EI2030/Caster/pcb/fpga.kicad_sch

## KiCad design pcb/fpga.kicad_sch (2021-05-30)

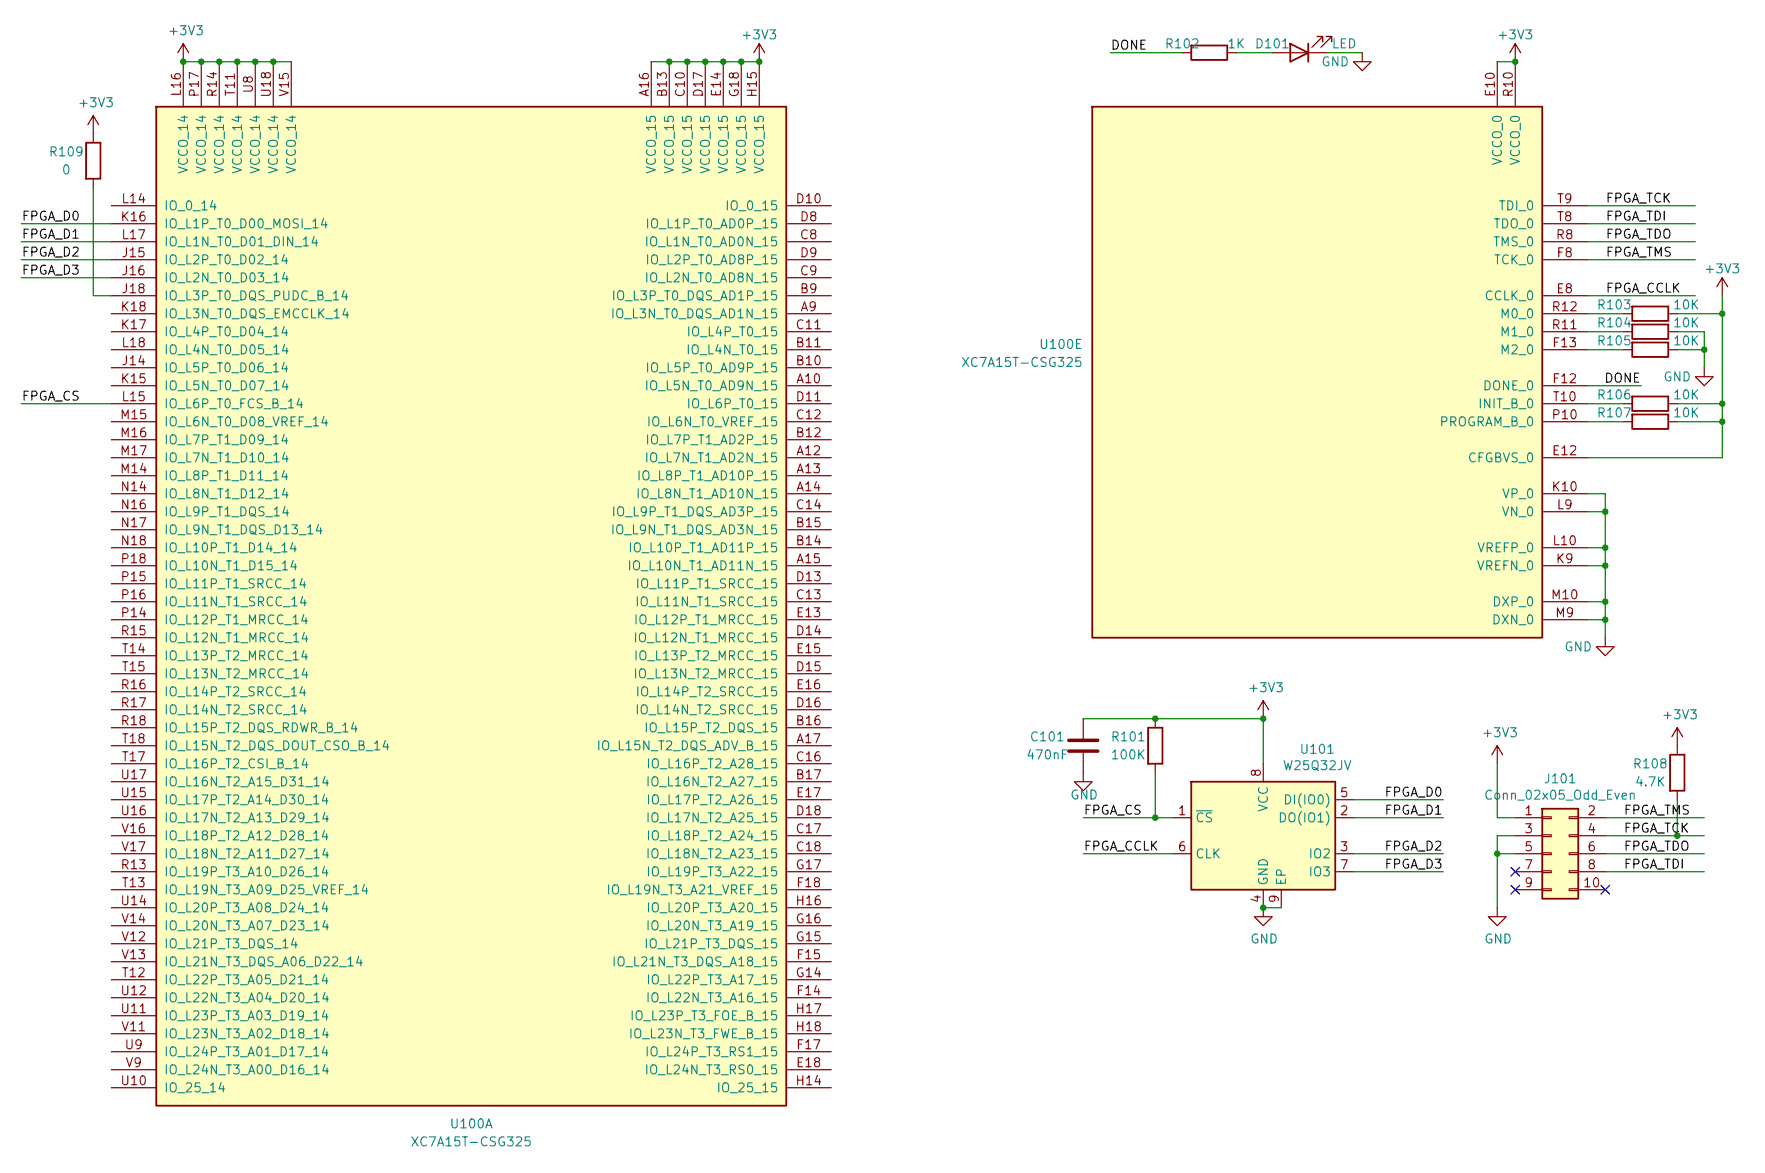
[picture p1: schematic fpga.kicad_sch]

Parts:
C101: 470nF; C_0402_1005Metric
D101: LED; D_0603_1608Metric
J101: Conn_02x05_Odd_Even; PinHeader_2x05_P1.27mm_Vertical_SMD
R101: 100K; C_0402_1005Metric
R102: 1K; R_0402_1005Metric
R103, R104, R105, R106, R107: 10K; R_0402_1005Metric
R108: 4.7K; R_0402_1005Metric
R109: 0; C_0402_1005Metric
U100: XC7A15T-CSG325; Xilinx_CSG325
U101: W25Q32JV; WSON-8-1EP_6x5mm_P1.27mm_EP3.4x4.3mm

Connections:
+3V3: C101.2, J101.1, R101.1, R103.1, R106.1, R107.1, R108.1, R109.1, U100.A16 (VCCO_15), U100.B13 (VCCO_15), U100.C10 (VCCO_15), U100.D17 (VCCO_15), U100.E10 (VCCO_0), U100.E12 (CFGBVS_0), U100.E14 (VCCO_15), U100.G18 (VCCO_15), U100.H15 (VCCO_15), U100.L16 (VCCO_14), U100.P17 (VCCO_14), U100.R10 (VCCO_0), U100.R14 (VCCO_14), U100.T11 (VCCO_14), U100.U8 (VCCO_14), U100.U18 (VCCO_14), U100.V15 (VCCO_14), U101.8 (VCC)
DONE: R102.2, U100.F12 (DONE_0)
FPGA_CCLK: U100.E8 (CCLK_0), U101.6 (CLK)
FPGA_CS: R101.2, U100.L15 (IO_L6P_T0_FCS_B_14), U101.1 (~CS)
FPGA_D0: U100.K16 (IO_L1P_T0_D00_MOSI_14), U101.5 (DI(IO0))
FPGA_D1: U100.L17 (IO_L1N_T0_D01_DIN_14), U101.2 (DO(IO1))
FPGA_D2: U100.J15 (IO_L2P_T0_D02_14), U101.3 (IO2)
FPGA_D3: U100.J16 (IO_L2N_T0_D03_14), U101.7 (IO3)
FPGA_TCK: J101.4, R108.2, U100.T9 (TDI_0)
FPGA_TDI: J101.8, U100.T8 (TDO_0)
FPGA_TDO: J101.6, U100.R8 (TMS_0)
FPGA_TMS: J101.2, U100.F8 (TCK_0)
GND: C101.1, D101.1 (K), J101.3, J101.5, R104.1, R105.1, U100.K9 (VREFN_0), U100.K10 (VP_0), U100.L9 (VN_0), U100.L10 (VREFP_0), U100.M9 (DXN_0), U100.M10 (DXP_0), U101.4 (GND), U101.9 (EP)
unnamed: D101.2 (A), R102.1
unnamed: R103.2, U100.R12 (M0_0)
unnamed: R104.2, U100.R11 (M1_0)
unnamed: R105.2, U100.F13 (M2_0)
unnamed: R106.2, U100.T10 (INIT_B_0)
unnamed: R107.2, U100.P10 (PROGRAM_B_0)
unnamed: R109.2, U100.J18 (IO_L3P_T0_DQS_PUDC_B_14)
