EI2030/Caster/pcb/lvds.kicad_sch

## KiCad design pcb/lvds.kicad_sch (2021-05-30)

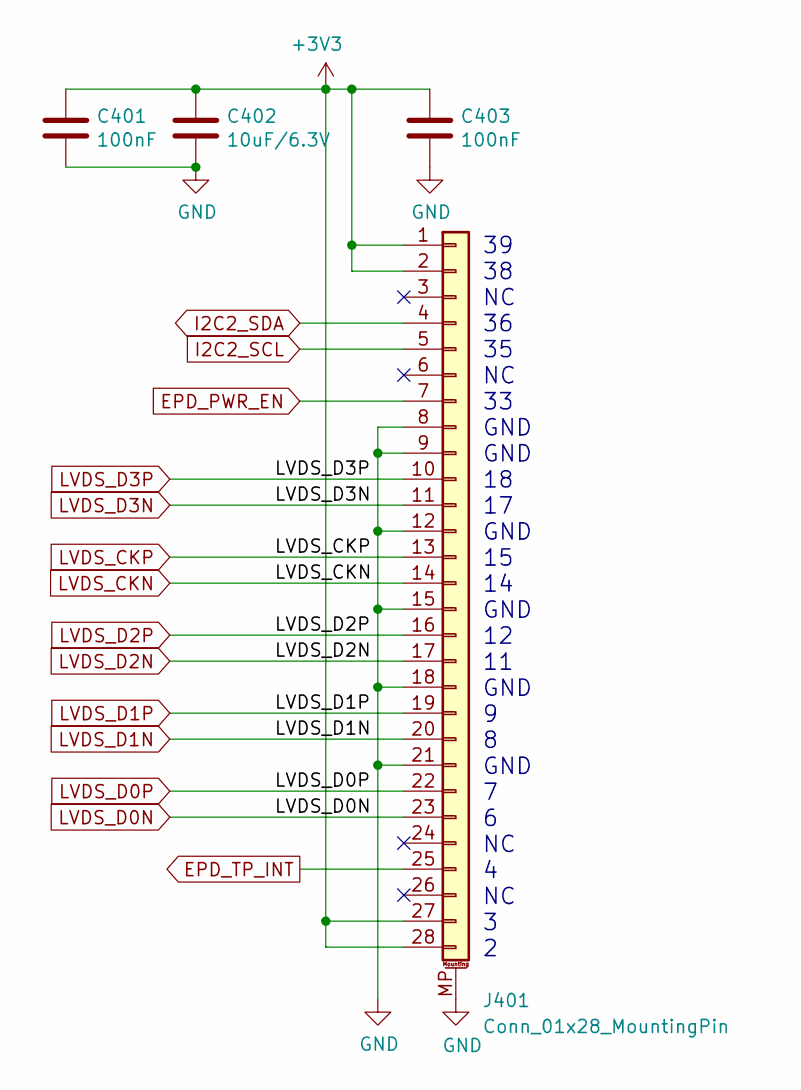
[picture p2: schematic lvds.kicad_sch]

Parts:
C401, C403: 100nF; C_0402_1005Metric
C402: 10uF/6.3V; C_0603_1608Metric
J401: Conn_01x28_MountingPin; Hirose_FH12-28S-0.5SH_1x28-1MP_P0.50mm_Horizontal

Connections:
+3V3: C401.1, C402.1, C403.1, J401.1, J401.2, J401.27, J401.28
EPD_PWR_EN: J401.7
EPD_TP_INT: J401.25
GND: C401.2, C402.2, C403.2, J401.8, J401.9, J401.12, J401.15, J401.18, J401.21, J401.MP (MountPin)
I2C2_SCL: J401.5
I2C2_SDA: J401.4
LVDS_CKN: J401.14
LVDS_CKP: J401.13
LVDS_D0N: J401.23
LVDS_D0P: J401.22
LVDS_D1N: J401.20
LVDS_D1P: J401.19
LVDS_D2N: J401.17
LVDS_D2P: J401.16
LVDS_D3N: J401.11
LVDS_D3P: J401.10

Notes on the sheet:
39 38 NC 36 35 NC 33 GND GND 18 17 GND 15 14 GND 12 11 GND 9 8 GND 7 6 NC 4 NC 3 2
