EI2030/Caster/pcb/pcie.kicad_sch

## KiCad design pcb/pcie.kicad_sch (2021-05-30)

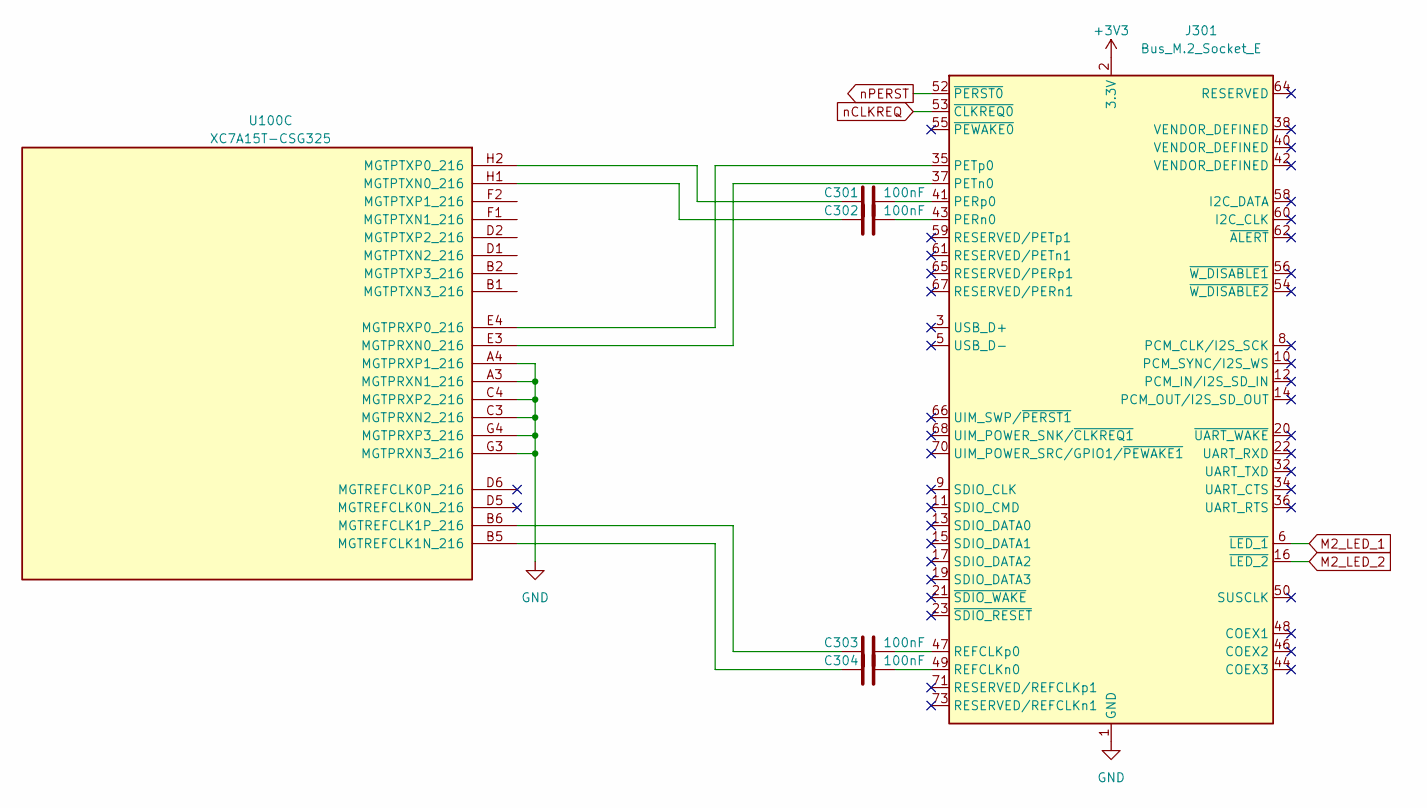
[picture p3: schematic pcie.kicad_sch]

Parts:
C301, C302, C303, C304: 100nF; C_0402_1005Metric
J301: Bus_M.2_Socket_E; m2-padKeyAE
U100: XC7A15T-CSG325; Xilinx_CSG325

Connections:
+3V3: J301.2 (3.3V), J301.4 (3.3V), J301.72 (3.3V), J301.74 (3.3V)
GND: J301.1 (GND), J301.7 (GND), J301.18 (GND), J301.33 (GND), J301.39 (GND), J301.45 (GND), J301.51 (GND), J301.57 (GND), J301.63 (GND), J301.69 (GND), J301.75 (GND), U100.A3 (MGTPRXN1_216), U100.A4 (MGTPRXP1_216), U100.C3 (MGTPRXN2_216), U100.C4 (MGTPRXP2_216), U100.G3 (MGTPRXN3_216), U100.G4 (MGTPRXP3_216)
M2_LED_1: J301.6 (~LED_1)
M2_LED_2: J301.16 (~LED_2)
unnamed: C301.1, U100.H2 (MGTPTXP0_216)
unnamed: C301.2, J301.41 (PERp0)
unnamed: C302.1, U100.H1 (MGTPTXN0_216)
unnamed: C302.2, J301.43 (PERn0)
unnamed: C303.1, U100.B6 (MGTREFCLK1P_216)
unnamed: C303.2, J301.47 (REFCLKp0)
unnamed: C304.1, U100.B5 (MGTREFCLK1N_216)
unnamed: C304.2, J301.49 (REFCLKn0)
unnamed: J301.35 (PETp0), U100.E4 (MGTPRXP0_216)
unnamed: J301.37 (PETn0), U100.E3 (MGTPRXN0_216)
nCLKREQ: J301.53 (~CLKREQ0)
nPERST: J301.52 (~PERST0)
