EI2030/Caster/pcb/power.kicad_sch

## KiCad design pcb/power.kicad_sch (2021-05-30)

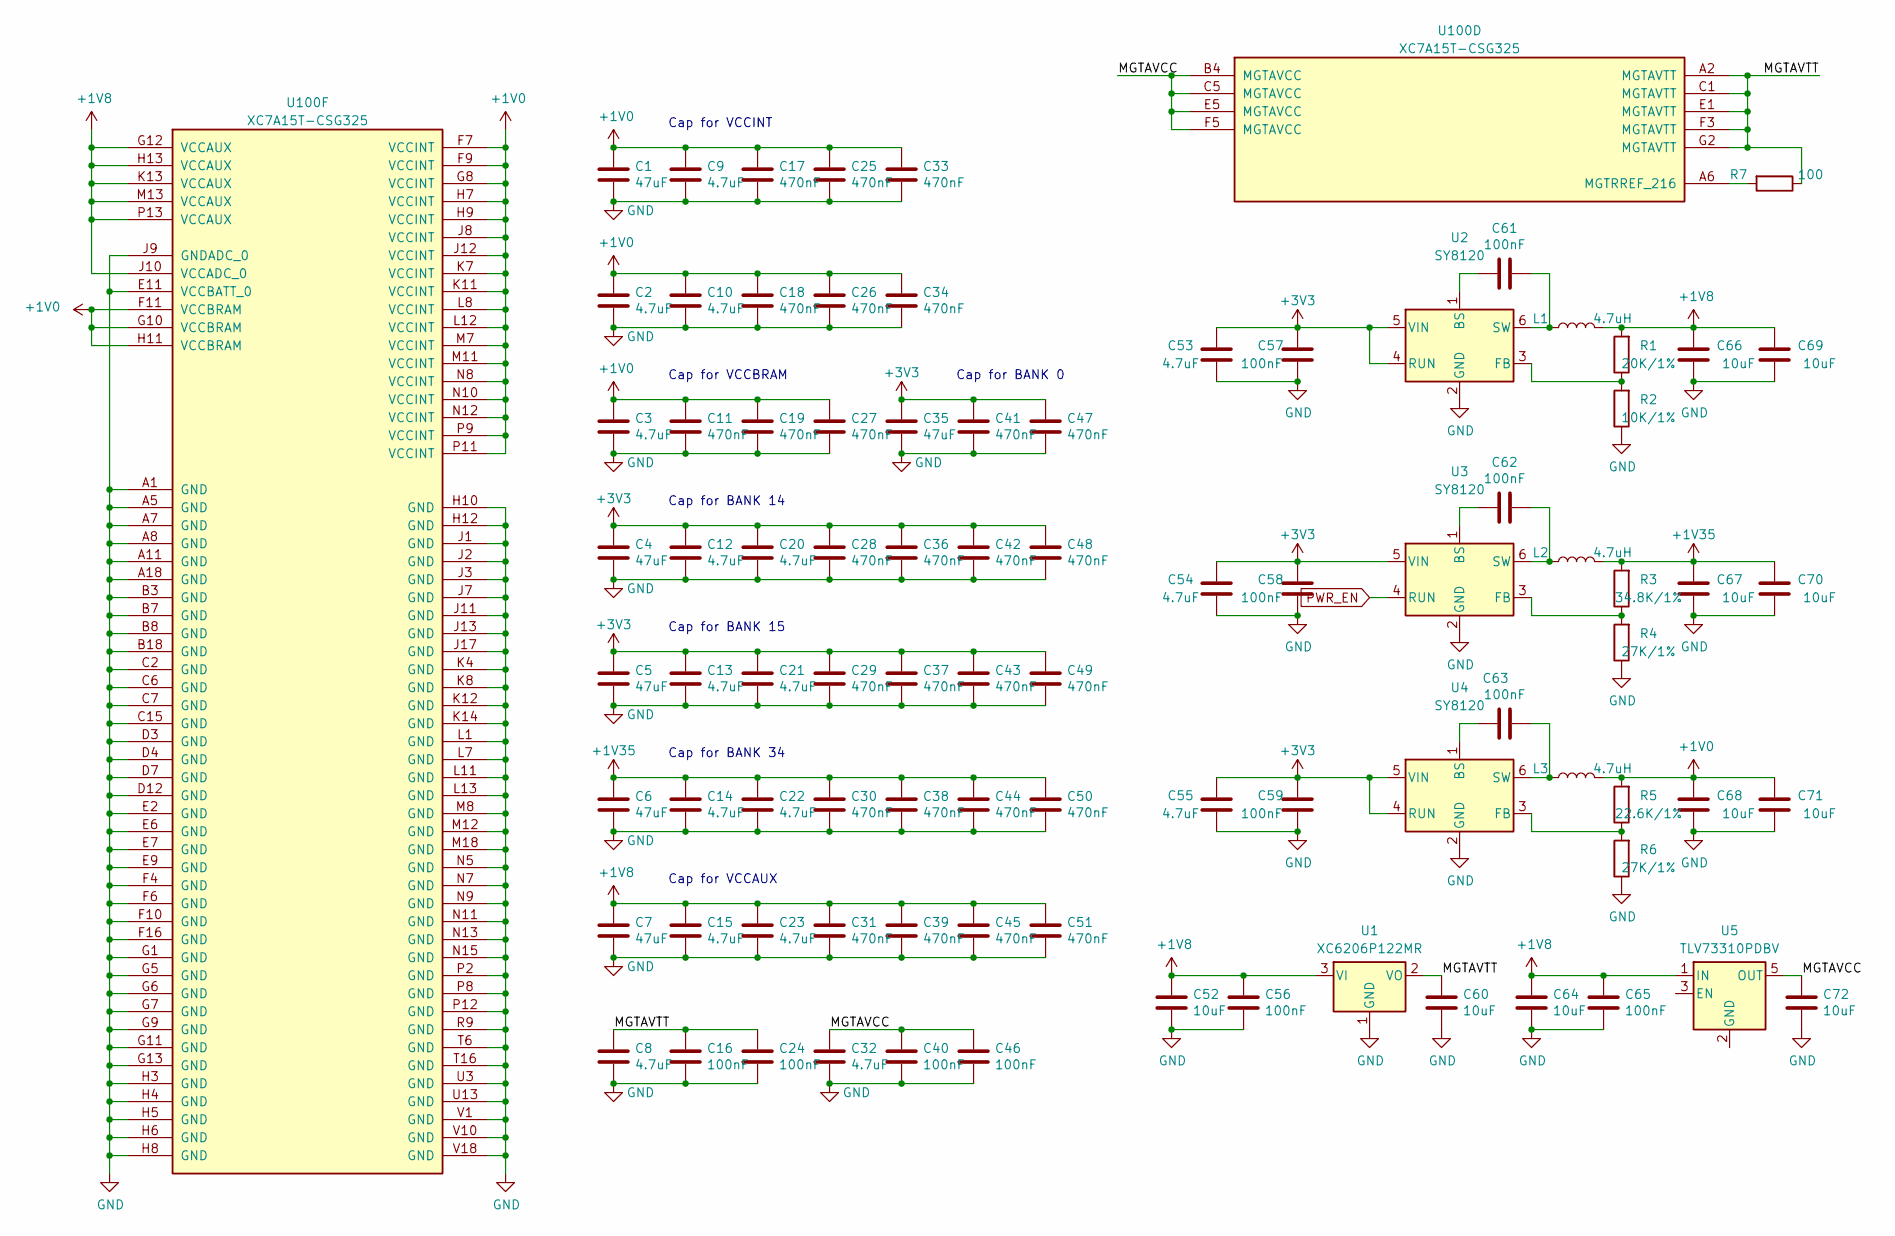
[picture p4: schematic power.kicad_sch]

Parts:
C1, C4, C5, C6, C7, C35: 47uF; C_0603_1608Metric
C2, C3, C8, C9, C10, C12, C13, C14, C15, C20, C21, C22, C23, C32, C53, C54, C55: 4.7uF; C_0402_1005Metric
C11, C17, C18, C19, C25, C26, C27, C28, C29, C30, C31, C33, C34, C36, C37, C38, C39, C41, C42, C43, C44, C45, C47, C48, C49, C50, C51: 470nF; C_0402_1005Metric
C16, C24, C40, C46, C56, C57, C58, C59, C61, C62, C63, C65: 100nF; C_0402_1005Metric
C52, C60, C64, C66, C67, C68, C69, C70, C71, C72: 10uF; C_0603_1608Metric
L1, L2, L3: 4.7uH; L_Vishay_IHLP-1212
R1: 20K/1%; R_0402_1005Metric
R2: 10K/1%; R_0402_1005Metric
R3: 34.8K/1%; R_0402_1005Metric
R4, R6: 27K/1%; R_0402_1005Metric
R5: 22.6K/1%; R_0402_1005Metric
R7: 100; R_0402_1005Metric
U1: XC6206P122MR; SOT-23
U2, U3, U4: SY8120; TSOT-23-6
U5: TLV73310PDBV; SOT-23-5
U100: XC7A15T-CSG325; Xilinx_CSG325

Connections:
+1V0: C1.1, C2.1, C3.1, C9.1, C10.1, C11.1, C17.1, C18.1, C19.1, C25.1, C26.1, C27.1, C33.1, C34.1, C68.2, C71.2, L3.2, R5.2, U100.F7 (VCCINT), U100.F9 (VCCINT), U100.F11 (VCCBRAM), U100.G8 (VCCINT), U100.G10 (VCCBRAM), U100.H7 (VCCINT), U100.H9 (VCCINT), U100.H11 (VCCBRAM), U100.J8 (VCCINT), U100.J12 (VCCINT), U100.K7 (VCCINT), U100.K11 (VCCINT), U100.L8 (VCCINT), U100.L12 (VCCINT), U100.M7 (VCCINT), U100.M11 (VCCINT), U100.N8 (VCCINT), U100.N10 (VCCINT), U100.N12 (VCCINT), U100.P9 (VCCINT), U100.P11 (VCCINT)
+1V8: C7.1, C15.1, C23.1, C31.1, C39.1, C45.1, C51.1, C52.1, C56.1, C64.1, C65.1, C66.2, C69.2, L1.2, R1.2, U1.3 (VI), U5.1 (IN), U100.G12 (VCCAUX), U100.H13 (VCCAUX), U100.J10 (VCCADC_0), U100.K13 (VCCAUX), U100.M13 (VCCAUX), U100.P13 (VCCAUX)
+1V35: C6.1, C14.1, C22.1, C30.1, C38.1, C44.1, C50.1, C67.2, C70.2, L2.2, R3.2
+3V3: C4.1, C5.1, C12.1, C13.1, C20.1, C21.1, C28.1, C29.1, C35.1, C36.1, C37.1, C41.1, C42.1, C43.1, C47.1, C48.1, C49.1, C53.2, C54.2, C55.2, C57.2, C58.2, C59.2, U2.4 (RUN), U2.5 (VIN), U3.5 (VIN), U4.4 (RUN), U4.5 (VIN)
GND: C1.2, C2.2, C3.2, C4.2, C5.2, C6.2, C7.2, C8.2, C9.2, C10.2, C11.2, C12.2, C13.2, C14.2, C15.2, C16.2, C17.2, C18.2, C19.2, C20.2, C21.2, C22.2, C23.2, C24.2, C25.2, C26.2, C27.2, C28.2, C29.2, C30.2, C31.2, C32.2, C33.2, C34.2, C35.2, C36.2, C37.2, C38.2, C39.2, C40.2, C41.2, C42.2, C43.2, C44.2, C45.2, C46.2, C47.2, C48.2, C49.2, C50.2, C51.2, C52.2, C53.1, C54.1, C55.1, C56.2, C57.1, C58.1, C59.1, C60.2, C64.2, C65.2, C66.1, C67.1, C68.1, C69.1, C70.1, C71.1, C72.2, R2.1, R4.1, R6.1, U1.1 (GND), U2.2 (GND), U3.2 (GND), U4.2 (GND), U100.A1 (GND), U100.A5 (GND), U100.A7 (GND), U100.A8 (GND), U100.A11 (GND), U100.A18 (GND), U100.B3 (GND), U100.B7 (GND), U100.B8 (GND), U100.B18 (GND), U100.C2 (GND), U100.C6 (GND), U100.C7 (GND), U100.C15 (GND), U100.D3 (GND), U100.D4 (GND), U100.D7 (GND), U100.D12 (GND), U100.E2 (GND), U100.E6 (GND), U100.E7 (GND), U100.E9 (GND), U100.E11 (VCCBATT_0), U100.F4 (GND), U100.F6 (GND), U100.F10 (GND), U100.F16 (GND), U100.G1 (GND), U100.G5 (GND), U100.G6 (GND), U100.G7 (GND), U100.G9 (GND), U100.G11 (GND), U100.G13 (GND), U100.H3 (GND), U100.H4 (GND), U100.H5 (GND), U100.H6 (GND), U100.H8 (GND), U100.H10 (GND), U100.H12 (GND), U100.J1 (GND), U100.J2 (GND), U100.J3 (GND), U100.J7 (GND), U100.J9 (GNDADC_0), U100.J11 (GND), U100.J13 (GND), U100.J17 (GND), U100.K4 (GND), U100.K8 (GND), U100.K12 (GND), U100.K14 (GND), U100.L1 (GND), U100.L7 (GND), U100.L11 (GND), U100.L13 (GND), U100.M8 (GND), U100.M12 (GND), U100.M18 (GND), U100.N5 (GND), U100.N7 (GND), U100.N9 (GND), U100.N11 (GND), U100.N13 (GND), U100.N15 (GND), U100.P2 (GND), U100.P8 (GND), U100.P12 (GND), U100.R9 (GND), U100.T6 (GND), U100.T16 (GND), U100.U3 (GND), U100.U13 (GND), U100.V1 (GND), U100.V10 (GND), U100.V18 (GND)
MGTAVCC: C32.1, C40.1, C46.1, C72.1, U5.5 (OUT), U100.B4 (MGTAVCC), U100.C5 (MGTAVCC), U100.E5 (MGTAVCC), U100.F5 (MGTAVCC)
MGTAVTT: C8.1, C16.1, C24.1, C60.1, R7.1, U1.2 (VO), U100.A2 (MGTAVTT), U100.C1 (MGTAVTT), U100.E1 (MGTAVTT), U100.F3 (MGTAVTT), U100.G2 (MGTAVTT)
unnamed: C61.1, L1.1, U2.6 (SW)
unnamed: C61.2, U2.1 (BS)
unnamed: C62.1, L2.1, U3.6 (SW)
unnamed: C62.2, U3.1 (BS)
unnamed: C63.1, L3.1, U4.6 (SW)
unnamed: C63.2, U4.1 (BS)
unnamed: R1.1, R2.2, U2.3 (FB)
unnamed: R3.1, R4.2, U3.3 (FB)
unnamed: R5.1, R6.2, U4.3 (FB)
unnamed: R7.2, U100.A6 (MGTRREF_216)
PWR_EN: U3.4 (RUN)

Notes on the sheet:
Cap for VCCINT
Cap for VCCBRAM
Cap for BANK 14
Cap for BANK 15
Cap for BANK 34
Cap for VCCAUX
Cap for BANK 0
