EI2030/Caster/pcb/ram.kicad_sch

## KiCad design pcb/ram.kicad_sch (2021-05-30)

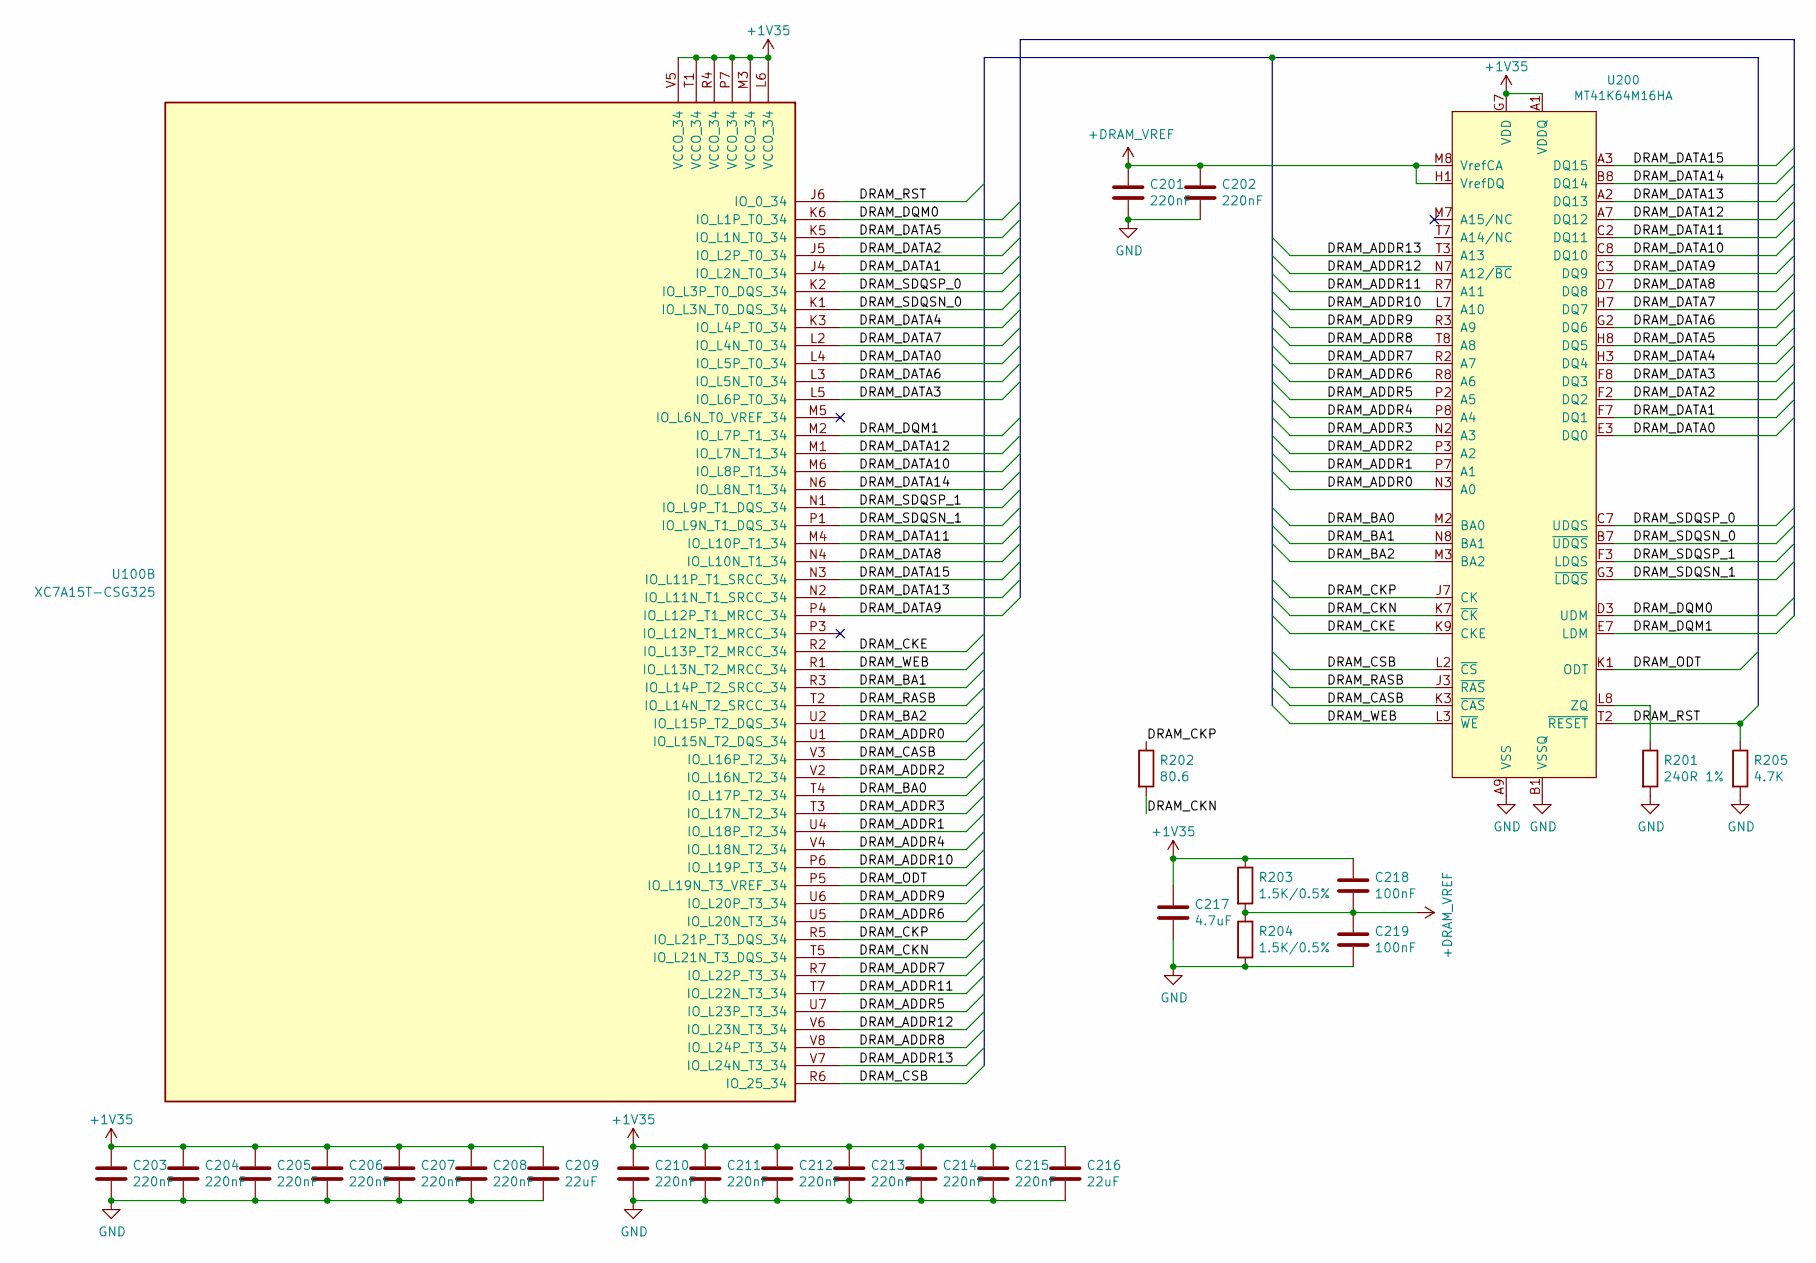
[picture p5: schematic ram.kicad_sch]

Parts:
C201, C202, C203, C204, C205, C206, C207, C208, C210, C211, C212, C213, C214, C215: 220nF; C_0402_1005Metric
C209, C216: 22uF; C_0603_1608Metric
C217: 4.7uF; C_0603_1608Metric
C218, C219: 100nF; C_0402_1005Metric
R201: 240R 1%; R_0402_1005Metric
R202: 80.6; R_0402_1005Metric
R203, R204: 1.5K/0.5%; R_0402_1005Metric
R205: 4.7K; R_0402_1005Metric
U100: XC7A15T-CSG325; Xilinx_CSG325
U200: MT41K64M16HA; BGA-96_9.0x13.0mm_P0.8mm

Connections:
+1V35: C203.1, C204.1, C205.1, C206.1, C207.1, C208.1, C209.1, C210.1, C211.1, C212.1, C213.1, C214.1, C215.1, C216.1, C217.1, C218.1, R203.1, U100.L6 (VCCO_34), U100.M3 (VCCO_34), U100.P7 (VCCO_34), U100.R4 (VCCO_34), U100.T1 (VCCO_34), U100.V5 (VCCO_34), U200.A1 (VDDQ), U200.A8 (VDDQ), U200.B2 (VDD), U200.C1 (VDDQ), U200.C9 (VDDQ), U200.D2 (VDDQ), U200.D9 (VDD), U200.E9 (VDDQ), U200.F1 (VDDQ), U200.G7 (VDD), U200.H2 (VDDQ), U200.H9 (VDDQ), U200.K2 (VDD), U200.K8 (VDD), U200.N1 (VDD), U200.N9 (VDD), U200.R1 (VDD), U200.R9 (VDD)
+DRAM_VREF: C201.1, C202.1, C218.2, C219.1, R203.2, R204.1, U200.H1 (VrefDQ), U200.M8 (VrefCA)
DRAM_ADDR0: U100.U1 (IO_L15N_T2_DQS_34), U200.N3 (A0)
DRAM_ADDR1: U100.U4 (IO_L18P_T2_34), U200.P7 (A1)
DRAM_ADDR2: U100.V2 (IO_L16N_T2_34), U200.P3 (A2)
DRAM_ADDR3: U100.T3 (IO_L17N_T2_34), U200.N2 (A3)
DRAM_ADDR4: U100.V4 (IO_L18N_T2_34), U200.P8 (A4)
DRAM_ADDR5: U100.U7 (IO_L23P_T3_34), U200.P2 (A5)
DRAM_ADDR6: U100.U5 (IO_L20N_T3_34), U200.R8 (A6)
DRAM_ADDR7: U100.R7 (IO_L22P_T3_34), U200.R2 (A7)
DRAM_ADDR8: U100.V8 (IO_L24P_T3_34), U200.T8 (A8)
DRAM_ADDR9: U100.U6 (IO_L20P_T3_34), U200.R3 (A9)
DRAM_ADDR10: U100.P6 (IO_L19P_T3_34), U200.L7 (A10)
DRAM_ADDR11: U100.T7 (IO_L22N_T3_34), U200.R7 (A11)
DRAM_ADDR12: U100.V6 (IO_L23N_T3_34), U200.N7 (A12/~BC)
DRAM_ADDR13: U100.V7 (IO_L24N_T3_34), U200.T3 (A13)
DRAM_BA0: U100.T4 (IO_L17P_T2_34), U200.M2 (BA0)
DRAM_BA1: U100.R3 (IO_L14P_T2_SRCC_34), U200.N8 (BA1)
DRAM_BA2: U100.U2 (IO_L15P_T2_DQS_34), U200.M3 (BA2)
DRAM_CASB: U100.V3 (IO_L16P_T2_34), U200.K3 (~CAS)
DRAM_CKE: U100.R2 (IO_L13P_T2_MRCC_34), U200.K9 (CKE)
DRAM_CKN: R202.2, U100.T5 (IO_L21N_T3_DQS_34), U200.K7 (~CK)
DRAM_CKP: R202.1, U100.R5 (IO_L21P_T3_DQS_34), U200.J7 (CK)
DRAM_CSB: U100.R6 (IO_25_34), U200.L2 (~CS)
DRAM_DATA0: U100.L4 (IO_L5P_T0_34), U200.E3 (DQ0)
DRAM_DATA1: U100.J4 (IO_L2N_T0_34), U200.F7 (DQ1)
DRAM_DATA2: U100.J5 (IO_L2P_T0_34), U200.F2 (DQ2)
DRAM_DATA3: U100.L5 (IO_L6P_T0_34), U200.F8 (DQ3)
DRAM_DATA4: U100.K3 (IO_L4P_T0_34), U200.H3 (DQ4)
DRAM_DATA5: U100.K5 (IO_L1N_T0_34), U200.H8 (DQ5)
DRAM_DATA6: U100.L3 (IO_L5N_T0_34), U200.G2 (DQ6)
DRAM_DATA7: U100.L2 (IO_L4N_T0_34), U200.H7 (DQ7)
DRAM_DATA8: U100.N4 (IO_L10N_T1_34), U200.D7 (DQ8)
DRAM_DATA9: U100.P4 (IO_L12P_T1_MRCC_34), U200.C3 (DQ9)
DRAM_DATA10: U100.M6 (IO_L8P_T1_34), U200.C8 (DQ10)
DRAM_DATA11: U100.M4 (IO_L10P_T1_34), U200.C2 (DQ11)
DRAM_DATA12: U100.M1 (IO_L7N_T1_34), U200.A7 (DQ12)
DRAM_DATA13: U100.N2 (IO_L11N_T1_SRCC_34), U200.A2 (DQ13)
DRAM_DATA14: U100.N6 (IO_L8N_T1_34), U200.B8 (DQ14)
DRAM_DATA15: U100.N3 (IO_L11P_T1_SRCC_34), U200.A3 (DQ15)
DRAM_DQM0: U100.K6 (IO_L1P_T0_34), U200.D3 (UDM)
DRAM_DQM1: U100.M2 (IO_L7P_T1_34), U200.E7 (LDM)
DRAM_ODT: U100.P5 (IO_L19N_T3_VREF_34), U200.K1 (ODT)
DRAM_RASB: U100.T2 (IO_L14N_T2_SRCC_34), U200.J3 (~RAS)
DRAM_RST: R205.1, U100.J6 (IO_0_34), U200.T2 (~RESET)
DRAM_SDQSN_0: U100.K1 (IO_L3N_T0_DQS_34), U200.B7 (~UDQS)
DRAM_SDQSN_1: U100.P1 (IO_L9N_T1_DQS_34), U200.G3 (~LDQS)
DRAM_SDQSP_0: U100.K2 (IO_L3P_T0_DQS_34), U200.C7 (UDQS)
DRAM_SDQSP_1: U100.N1 (IO_L9P_T1_DQS_34), U200.F3 (LDQS)
DRAM_WEB: U100.R1 (IO_L13N_T2_MRCC_34), U200.L3 (~WE)
GND: C201.2, C202.2, C203.2, C204.2, C205.2, C206.2, C207.2, C208.2, C209.2, C210.2, C211.2, C212.2, C213.2, C214.2, C215.2, C216.2, C217.2, C219.2, R201.2, R204.2, R205.2, U200.A9 (VSS), U200.B1 (VSSQ), U200.B3 (VSS), U200.B9 (VSSQ), U200.D1 (VSSQ), U200.D8 (VSSQ), U200.E1 (VSS), U200.E2 (VSSQ), U200.E8 (VSSQ), U200.F9 (VSSQ), U200.G1 (VSSQ), U200.G8 (VSS), U200.G9 (VSSQ), U200.J2 (VSS), U200.J8 (VSS), U200.M1 (VSS), U200.M9 (VSS), U200.P1 (VSS), U200.P9 (VSS), U200.T1 (VSS), U200.T9 (VSS)
unnamed: R201.1, U200.L8 (ZQ)
